Gilson-Android/hoverboard-esp32/TBS7960-Pinout.jpg

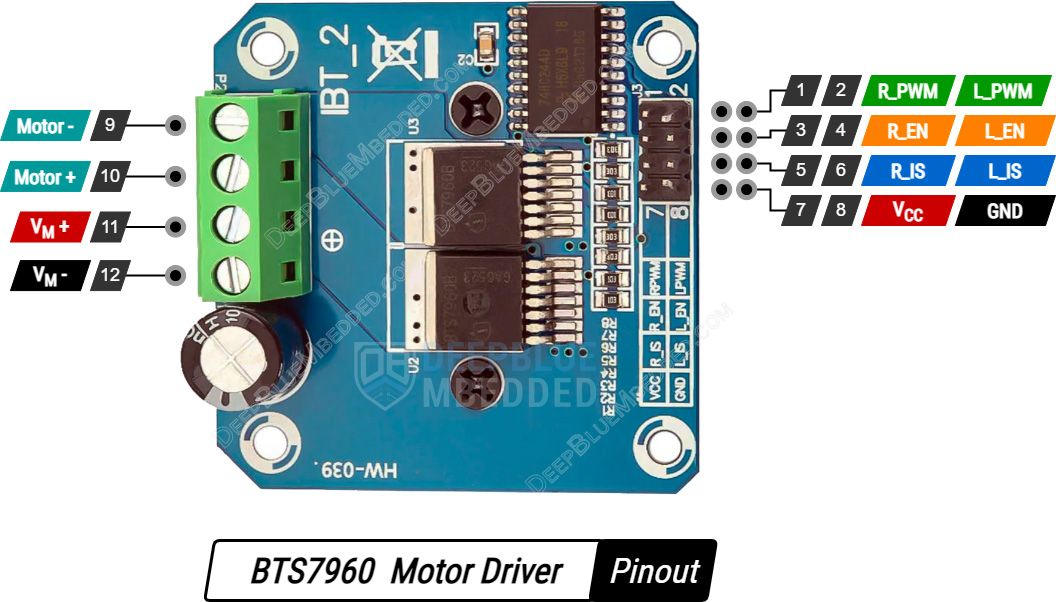
TBS7960-Pinout.jpg
