Gilson-Android/hoverboard-esp32/esp-32s v1.1 .jpeg

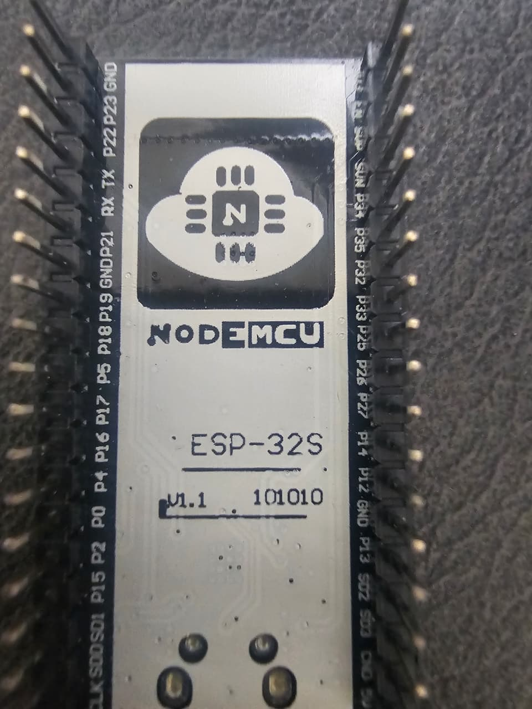
esp-32s v1.1 .jpeg
