Gilson-Android/hoverboard-esp32/fs-ia6B 3.webp

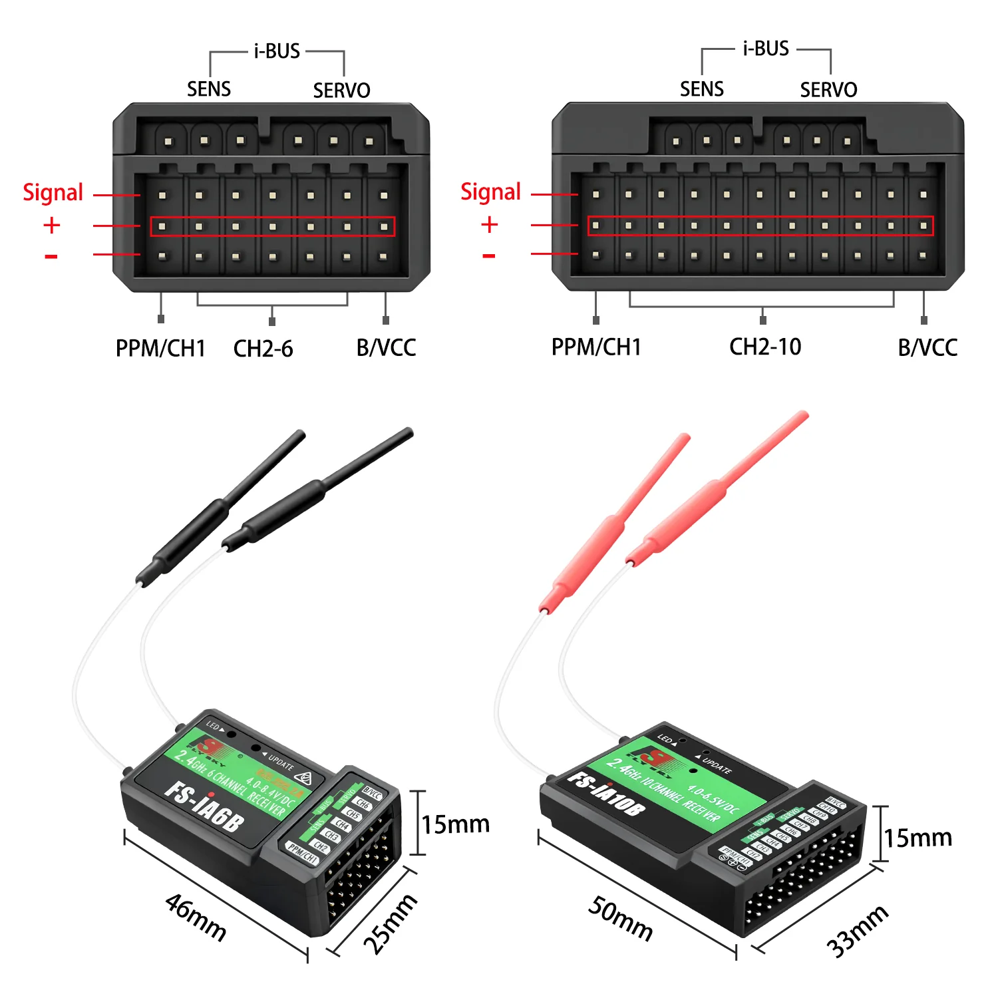
fs-ia6B 3.webp
