Gilson-Android/hoverboard-esp32/(commit log)

2026-05-23 Guia de montagem ESP32 + BTS7960
2026-05-23 Renomeia para index.html para GitHub Pages
2026-05-23 Adiciona imagens e sketch Arduino
2026-05-24 Adiciona passo Arduino IDE, GPIOs corretos (12/14) e codigo real do .ino
2026-06-03 Corrige pino de alimentacao: VIN -> 5V0 (ESP32-S v1.1)
    O ESP32-S v1.1 nao tem pino VIN — o pino correto e o 5V0
    (ultimo pino, lado esquerdo). Remove aviso incorreto sobre
    nao usar o pino 5V como entrada, pois nessa placa o 5V0
    e a unica entrada de alimentacao 5V disponivel.
2026-06-03 Corrige fonte do VCC dos drivers: ESP32 5V0 -> MP1584 OUT+
    Os drivers recebem 5V diretamente do MP1584 (ramais paralelos),
    nao via pino 5V0 do ESP32. Atualiza checklists, conn-rows
    e tabela de resumo nos tres arquivos.
2026-06-03 Adiciona lightbox para ampliar imagens ao clicar
    Todas as imagens de pinout (ESP32, BTS7960, MP1584) ficam
    clicaveis e abrem em overlay fullscreen. Fechar com clique
    fora, no X ou tecla Escape. Implementado em index.html
    e guia-completo.html.
2026-06-03 Corrige zoom: adiciona onclick na imagem ESP32 do painel t3b
    A imagem ESP-32S no Passo 3 (Motor Esquerdo) estava sem
    o onclick do lightbox.
2026-06-04 Adiciona modo dual: Xbox (BT) + radio FS-i6X (iBUS)
    Maquina de estados WAITING -> XBOX ou RADIO conforme
    primeiro sinal detectado. Perda de sinal retorna a WAITING.
    LED: pisca lento = aguardando, solido = Xbox, duplo pisca = radio.
    iBUS no GPIO 13 via UART1. Requer biblioteca IBusBM.
2026-06-04 Adiciona Passo 5: conexao receptor FS-iA6B (modo radio)
    Novo passo com checklist de ligacao, mapeamento de canais,
    imagens do receptor (pinout, conector iBUS, ESP32) e teste
    de validacao. Passo opcional — codigo Final renumerado p/ 6.
    Imagens fs-ia6B adicionadas ao repositorio.
2026-06-04 Substitui IBusBM por implementacao iBUS interna (fix ESP32 Core 3.x)
    IBusBM usa API de timer obsoleta (timerBegin/timerAlarmWrite)
    incompativel com ESP32 Arduino Core 3.x. Implementacao propria
    via polling de HardwareSerial, sem dependencia externa.
    [hovercomesp32D0WDQ6.ino]
2026-06-04 Atualiza titulo do guia para incluir modo radio FS-i6X
2026-06-04 Corrige fonte 5V do FS-iA6B: ESP32 5V0 -> MP1584 OUT+
    Ramal direto do MP1584, paralelo aos drivers e ESP32.
2026-06-10 Adiciona pistao eletrico da lamina (SwC/CH6) e move chave da lamina para CH7
    - Atuador linear de cadeira de rodas em BTS7960 (GPIO 25/26)
    - SwC 3 posicoes no CH6: cima=abre, meio=parado, baixo=fecha
    - Logica conforme fiacao medida: saida 0 abre, RPWM alto = parado
    - parar_pistao() em todos os caminhos de seguranca + boot
    - Lamina ON/OFF movida do CH10 para CH7 (SwA)
    - Guia: mapeamento de canais, tabela de controles, sketch e conexoes
    - Guia: secao de Failsafe obrigatorio (FS-iA6B mantem iBUS com radio desligado)
    [hovercomesp32D0WDQ6.ino]
2026-06-10 Adiciona trava de failsafe via canal sentinela CH9
    - Radio desligado: FS-iA6B segue enviando iBUS, mas CH9 (sem chave) salta
    de 1000 para 2000 - codigo detecta e para motores, pistao e lamina
    - Desarma e bloqueia reentrada no modo RADIO enquanto failsafe ativo
    - Guia: CH9 sentinela no mapeamento, failsafe e tabela de controles
    - Guia: alerta para salvar CH7 com SwA em OFF (salvo em ON liga a lamina)
    [hovercomesp32D0WDQ6.ino]
2026-06-10 Corta toda energia do atuador quando nao ha comunicacao com o radio
    - Nova funcao desenergizar_pistao() (0/0) usada no boot, modo aguardando,
    trava de failsafe (CH9), perda de sinal e desconexao do Xbox
    - parar_pistao() (segurar parado, RPWM alto) passa a ser usado apenas
    durante operacao com radio conectado
    - Guia atualizado (sketch embutido, failsafe e tabela de controles)
    [hovercomesp32D0WDQ6.ino]
2026-06-10 Move sentinela de failsafe do CH9 para o CH10
    - CH9 espelha a SwA no radio: ligar a lamina disparava a trava e
    derrubava o modo radio
    - CH10 e livre (None, ~1500 normal) e ja tem failsafe +100% salvo:
    radio desligado -> 2000, assinatura perfeita de sentinela
    - Limiar ajustado para 1700 (normal 1500 vs failsafe 2000)
    - Guia atualizado (mapeamento, failsafe, sketch e tabela)
    [hovercomesp32D0WDQ6.ino]
2026-06-10 Sentinela CH10 passa a usar SwD como chave de emergencia
    - Canal None nao grava failsafe: ao refazer o failsafe, CH10 passou a
    enviar 1500 e a trava nao disparava com o radio desligado
    - CH10 = SwD: opere com SwD OFF (1000); grave o failsafe com SwD ON
    (+100%) - radio desligado ou SwD ON = 2000 = trava tudo
    - SwD vira botao de emergencia fisico (kill manual)
    - Sem mudanca de logica no codigo, apenas comentarios e guia
    [hovercomesp32D0WDQ6.ino]
2026-06-10 Inverte sentinela: SwD ON habilita operacao, CH10 baixo trava tudo
    - Failsafe regravado com chaves erradas deixava a sentinela cega e o
    CH6 salvo em 1000 (comando abrir) mandava energia ao braco
    - Novo desenho: operar exige SwD ON (CH10=2000); SwD OFF, radio
    desligado ou failsafe (CH10=1000) cortam toda a energia
    - Gravacao natural do failsafe (sticks no centro, chaves desligadas)
    passa a ser a configuracao correta - elimina a classe de erro
    - Guia: regra de ouro do failsafe, SwD como habilitacao/emergencia
    [hovercomesp32D0WDQ6.ino]
2026-06-10 Atualiza guia com configuracao final do radio validada em bancada
    - CH7 = SwA (lamina), SwD reservada a habilitacao/emergencia (CH10)
    - Instrucoes de Aux channels com dica de salvar segurando Cancel
    - Failsafe: alerta que 'Off' mantem ultimo valor e os dois testes de
    validacao (SwD OFF e radio desligado)
    - Sequencia de operacao: TX -> energia -> SwD ON -> armar throttle
    [hovercomesp32D0WDQ6.ino]
2026-08-16 Documenta configuracao de 10 canais do FS-i6X e corrige porta iBUS
    O radio sai de fabrica como 6 canais: o menu Aux. channels so lista CH5
    e CH6, o CH10 nunca chega a 1700 e a trava do codigo mantem tudo
    desligado com o LED piscando lento. Passo que faltava: System setup ->
    Aux switches -> SwA..SwD On e Ch de 6 para 10.
    - Passo 5 ganha o bloco "Configuracao do FS-i6X" com o passo a passo
    completo, incluindo o aviso "turn off the receiver first" e a nota de
    re-bind apos mudar a contagem de canais.
    - Novo bloco de diagnostico: a linha [AGUARD] no Serial separa problema
    de fiacao de problema de configuracao.
    - Corrige a porta de sinal: i-BUS SERVO (fileira de cima, grupo da
    direita) em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
    [hovercomesp32D0WDQ6.ino, teste_ibus.ino]
